austinmartratt/LPTL/README.md

# LPTL
Low Power Temperature Logger - Bluetooth Low Energy
