austinmartratt/LPTL/LPTSV2_usingATmega328PV6.dxf

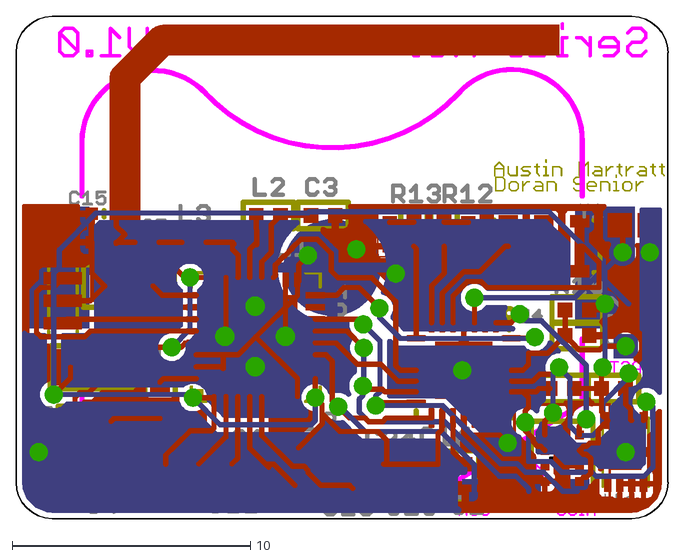
[picture p1: CAD file, 2023-06-24]
LPTSV2_usingATmega328PV6.dxf
27.4 x 21.1
