austinmartratt/LPTL/LPTSV2_usingATmega328PV6.brd

## EAGLE design LPTSV2_usingATmega328PV6.brd (2023-06-24)

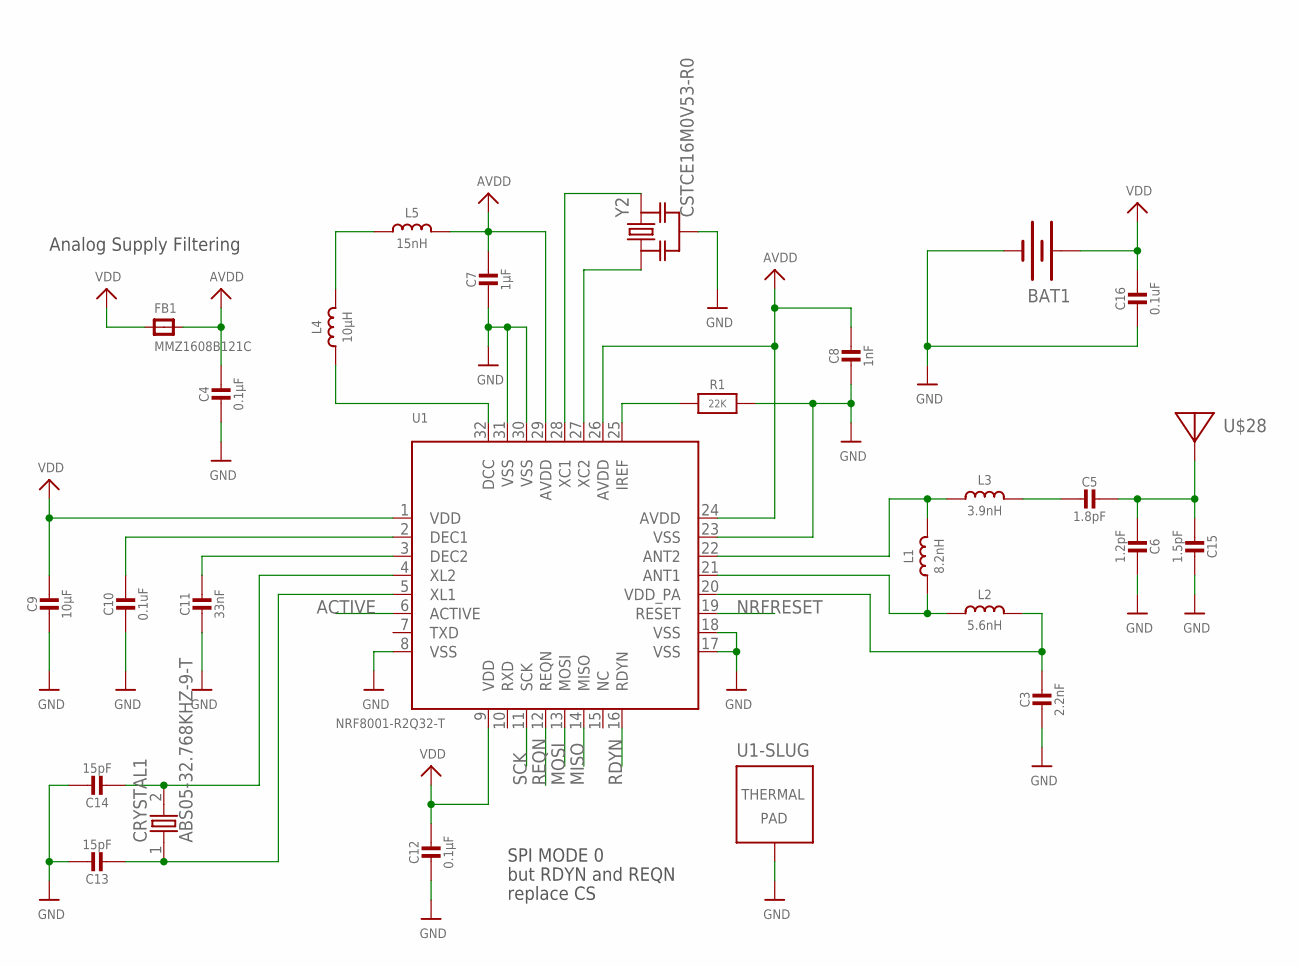
[picture p2: schematic LPTSV2_usingATmega328PV6.sch, sheet 2]

Parts:
BAT1: LINX-BAT-HLD-00120SMD; BATTCON_20MM; PARTNUMBER BAT-HLD-001-TRCT-ND
C3: 2.2nF; _0402; PARTNUMBER C0402C222J8JAC7867
C4, C12: 0.1µF; _0402; PARTNUMBER GRM155R71C104KA88J
C5: 1.8pF; _0402MP; PARTNUMBER GRM1555C1E1R8BA01D
C6: 1.2pF; _0402MP; PARTNUMBER GRM1555C1E1R2BA01D
C7: 1µF; _0402; PARTNUMBER 0402ZD105KAT2A
C8: 1nF; _0402; PARTNUMBER GRM155R71H102KA01D
C9: 10µF; _0402; PARTNUMBER GRM155R60J106ME15D
C10, C16: 0.1uF; _0402; PARTNUMBER GRM155R71C104KA88J
C11: 33nF; _0402; PARTNUMBER C0402C333K8RACTU
C13, C14: 15pF; _0402; PARTNUMBER GRM1555C1H150JA01D
C15: 1.5pF; _0402MP; PARTNUMBER GRM1555C1H1R5BA01D
CRYSTAL1: ABS05-32.768KHZ-9-T; CRYSTAL-2PIN
FB1: MMZ1608B121C; 0805; PARTNUMBER MMZ1608B121CTDH5
L1: 8.2nH; _0402; PARTNUMBER LQP15MN8N2B02D
L2: 5.6nH; _0402; PARTNUMBER LQP15MN5N6B02D
L3: 3.9nH; _0402; PARTNUMBER LQP03TN3N9B02D
L4: 10µH; _0603; PARTNUMBER LBMF1608T100K
L5: 15nH; _0603; PARTNUMBER L-14C15NJV4T
R1: 22K; _0805; PARTNUMBER RC0805JR-0722KL
U1: NRF8001-R2Q32-T; MICROBUILDER_QFN32_5MM
U$28: ANTENNA_PCBNRF8001_1.6MM; ANT_PCB_2.4GHZ_NRF8001_1.6MM_1OZ
Y2: CSTCE16M0V53-R0; RESONATOR_MURATA2

Connections:
ACTIVE: U1.6 (ACTIVE)
AVDD: C4.1, C7.1, C8.1, FB1.2, L5.2, U1.24 (AVDD), U1.26 (AVDD), U1.29 (AVDD)
GND: BAT1.2 (-), C3.2, C4.2, C6.1, C7.2, C8.2, C9.2, C10.2, C11.2, C12.2, C13.1, C14.1, C15.1, C16.2, R1.2, U1.8 (VSS), U1.17 (VSS), U1.18 (VSS), U1.23 (VSS), U1.30 (VSS), U1.31 (VSS), U1.33 (TP), Y2.2; also elsewhere on the board
MISO: U1.14 (MISO); also elsewhere on the board
MOSI: U1.13 (MOSI); also elsewhere on the board
unnamed: L1.2, L3.1, U1.22 (ANT2)
unnamed: L1.1, L2.1, U1.21 (ANT1)
unnamed: C3.1, L2.2, U1.20 (VDD_PA)
unnamed: L4.2, L5.1
unnamed: C5.2, L3.2
unnamed: C11.1, U1.3 (DEC2)
unnamed: C10.1, U1.2 (DEC1)
unnamed: U1.28 (XC1), Y2.3
unnamed: U1.27 (XC2), Y2.1
unnamed: L4.1, U1.32 (DCC)
unnamed: R1.1, U1.25 (IREF)
unnamed: C5.1, C6.2, C15.2, U$28.FEED
unnamed: C14.2, CRYSTAL1.2, U1.4 (XL2)
unnamed: C13.2, CRYSTAL1.1, U1.5 (XL1)
NRFRESET: U1.19 (RESET); also elsewhere on the board
RDYN: U1.16 (RDYN); also elsewhere on the board
REQN: U1.12 (REQN); also elsewhere on the board
SCK: U1.11 (SCK); also elsewhere on the board
VDD: BAT1.1 (+), BAT1.3 (+), C9.1, C12.1, C16.1, FB1.1, U1.1 (VDD), U1.9 (VDD); also elsewhere on the board

Notes on the sheet:
Analog Supply Filtering
SPI MODE 0
but RDYN and REQN
replace CS

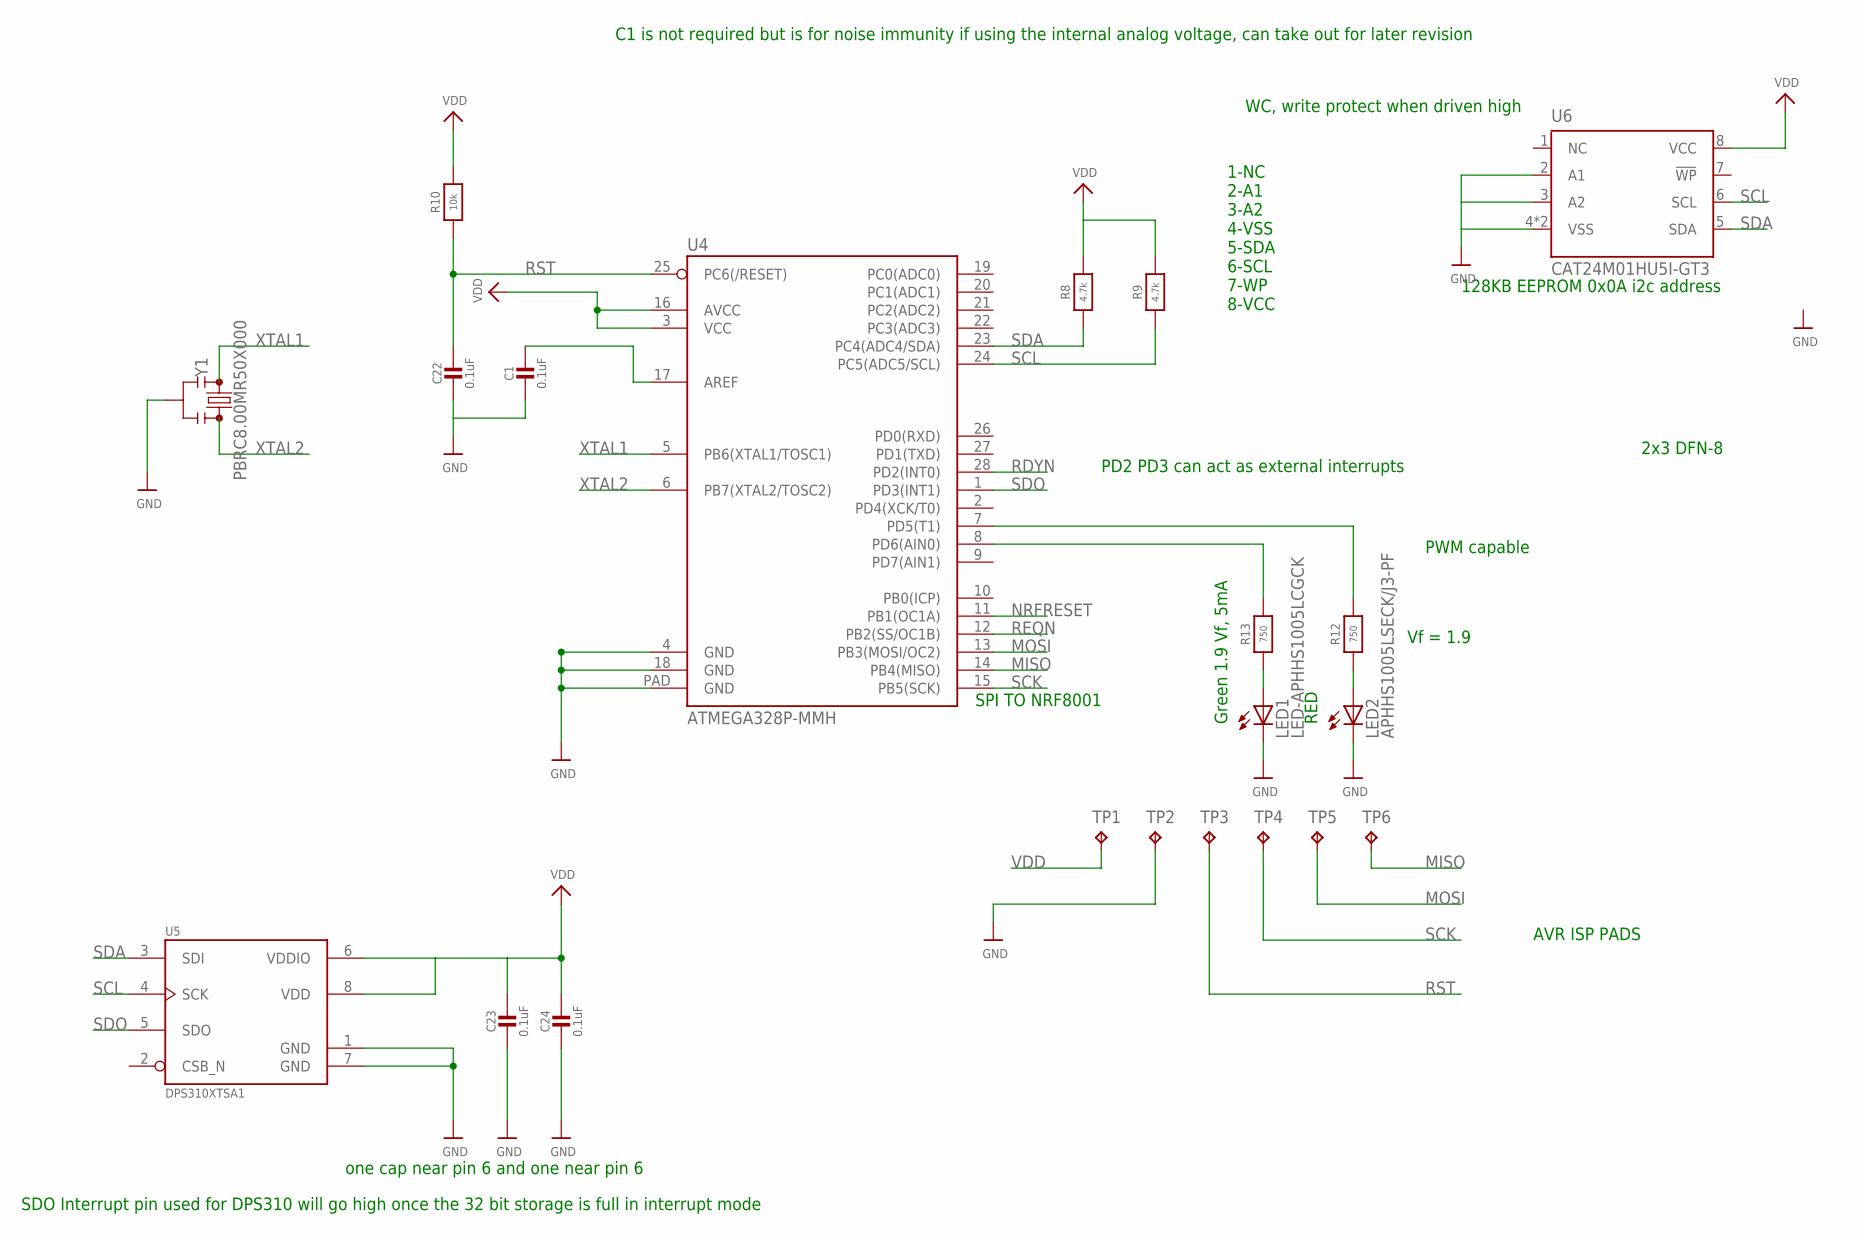
[picture p3: schematic LPTSV2_usingATmega328PV6.sch, sheet 3]

Parts:
C1, C22, C23, C24: 0.1uF; _0402; PARTNUMBER GRM155R71C104KA88J
LED1: LED-APHHS1005LCGCK; 0402-LED
LED2: APHHS1005LSECK/J3-PF; 0402-LED
R8, R9: 4.7k; _0402; PARTNUMBER RC0402JR-074K7L
R10: 10k; _0402; PARTNUMBER RC0402JR-0710KL
R12, R13: 750; _0402; PARTNUMBER RC0402JR-07750RL
TP1, TP2, TP3, TP4, TP5, TP6: TPTP10SQ; TP10SQ
U4: ATMEGA328P-MMH; SPARKFUN-IC-MICROCONTROLLER_VQFN-28
U5: DPS310XTSA1; LGA8S145X65P2X4_200X250X100
U6: CAT24M01HU5I-GT3; DFN-2X3
Y1: PBRC8.00MR50X000; RESONATOR-SMD-4.5X2.0

Connections:
GND: C1.2, C22.2, C23.2, C24.2, LED1.C, LED2.C, TP2.TP, U4.4 (GND), U4.18 (GND), U4.PAD (GND), U5.1 (GND), U5.7 (GND), U6.2 (A1), U6.3 (A2), U6.4 (VSS), U6.EXP (VSS), Y1.2; also elsewhere on the board
MISO: TP6.TP, U4.14 (PB4(MISO)); also elsewhere on the board
MOSI: TP5.TP, U4.13 (PB3(MOSI/OC2)); also elsewhere on the board
unnamed: R12.2, U4.7 (PD5(T1))
unnamed: R13.2, U4.8 (PD6(AIN0))
unnamed: LED1.A, R13.1
unnamed: LED2.A, R12.1
unnamed: C1.1, U4.17 (AREF)
NRFRESET: U4.11 (PB1(OC1A)); also elsewhere on the board
RDYN: U4.28 (PD2(INT0)); also elsewhere on the board
REQN: U4.12 (PB2(SS/OC1B)); also elsewhere on the board
RST: C22.1, R10.1, TP3.TP, U4.25 (PC6(/RESET))
SCK: TP4.TP, U4.15 (PB5(SCK)); also elsewhere on the board
SCL: R9.1, U4.24 (PC5(ADC5/SCL)), U5.4 (SCK), U6.6 (SCL)
SDA: R8.1, U4.23 (PC4(ADC4/SDA)), U5.3 (SDI), U6.5 (SDA)
SDO: U4.1 (PD3(INT1)), U5.5 (SDO)
VDD: C23.1, C24.1, R8.2, R9.2, R10.2, TP1.TP, U4.3 (VCC), U4.16 (AVCC), U5.6 (VDDIO), U5.8 (VDD), U6.8 (VCC); also elsewhere on the board
XTAL1: U4.5 (PB6(XTAL1/TOSC1)), Y1.1
XTAL2: U4.6 (PB7(XTAL2/TOSC2)), Y1.3

Notes on the sheet:
one cap near pin 6 and one near pin 6
SPI TO NRF8001
PD2 PD3 can act as external interrupts
SDO Interrupt pin used for DPS310 will go high once the 32 bit storage is full in interrupt mode
Green 1.9 Vf, 5mA
RED
AVR ISP PADS
PWM capable
C1 is not required but is for noise immunity if using the internal analog voltage, can take out for later revision
Vf = 1.9
2x3 DFN-8
1-NC 2-A1 3-A2 4-VSS 5-SDA 6-SCL 7-WP 8-VCC
WC, write protect when driven high
128KB EEPROM 0x0A i2c address

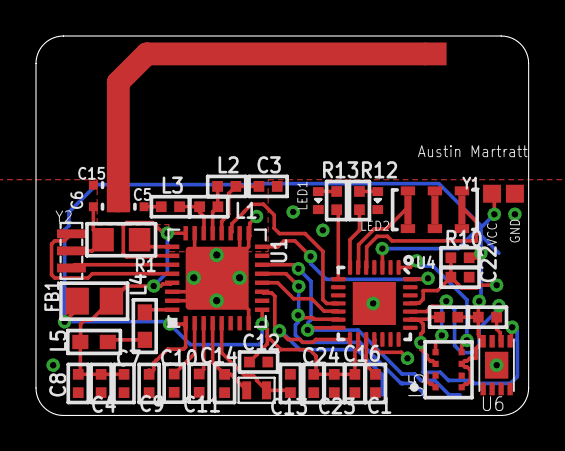
[picture p4: board LPTSV2_usingATmega328PV6.brd from above]

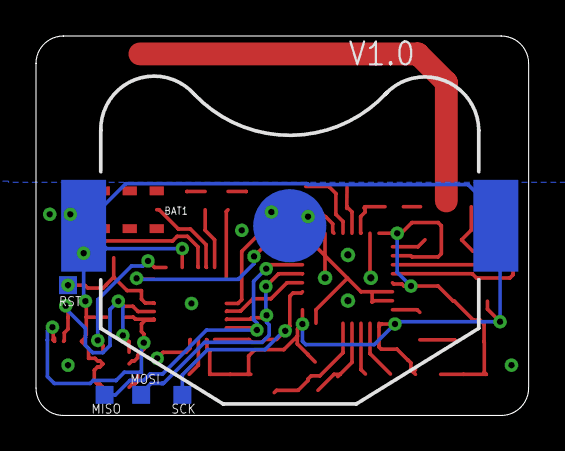
[picture p5: board LPTSV2_usingATmega328PV6.brd from below]

Board: 2 copper layers, 27.4 x 21.1 mm, 47 parts (5 on the bottom side), 34 nets.
